joaoPauloPimentel/UNIVERSAL-MODULAR-EAR-MOUNTED-HEADPHONE-40-TO-600-MM-DRIVERS/README.md

# UNIVERSAL-MODULAR-EAR-MOUNTED-HEADPHONE-40-TO-600-MM-DRIVERS
