joaoPauloPimentel/UNIVERSAL-MODULAR-EAR-MOUNTED-HEADPHONE-40-TO-600-MM-DRIVERS/umeh2/BOM.csv

item | qty_per_pair | material | printed | source | mass_each_g | spec | tag
Cradle ring (R and L) | 2 | PETG | yes | stl/common/ring_R.stl, ring_L.stl | 33.85 | ring OD 88.7 mm, UMI-2 twist-lock groove, 5 tabs (tab radius 63.20 mm); head face down; 5 perimeters, 30 % gyroid | CAD
Saddle arm (auricle-root arch) | 2 | PETG | yes | stl/common/arm_saddle.stl | 8.47 | bar 5.5 / leg 5.5 / foot 4.5 mm, serrated clamp p 1.2 mm; printed on its side; 5 perimeters, 40 % infill | CAD
Temporal arm | 2 | PETG | yes | stl/common/arm_temporal.stl | 3.16 | bar 5.5 / leg 5.5 / foot 4.5 mm, serrated clamp p 1.2 mm; printed on its side; 5 perimeters, 40 % infill | CAD
Mastoid arm | 2 | PETG | yes | stl/common/arm_mastoid.stl | 3.36 | bar 5.5 / leg 5.5 / foot 6.0 mm, serrated clamp p 1.2 mm; printed on its side; 5 perimeters, 40 % infill | CAD
Posterior-superior arm | 2 | PETG | yes | stl/common/arm_post.stl | 3.08 | bar 5.5 / leg 5.5 / foot 4.5 mm, serrated clamp p 1.2 mm; printed on its side; 5 perimeters, 40 % infill | CAD
Saddle cap | 2 | TPU 95A | yes | stl/common/saddle_cap.stl | 6.83 | arched cap on the auricle root; flat, skin face down; the bearing face is recessed 2.5 mm for the cast liner | CAD
Saddle liner (soft silicone, cast into the cap's bearing face) | 2 | skin-safe platinum silicone Shore 00-30 (100 % modulus ~69 kPa) | no (cast) | stl/common/cast_reference/saddle_liner.stl (mould reference) | 0.92 | 2.5 mm, softens the auricle-root contact (root pressure <= 4 kPa at 55-60 mm, report §6); prime the TPU or key it mechanically; replace with the cap | C
Pad, temporal | 2 | TPU 95A, 15 % gyroid | yes | stl/common/pad_temporal.stl | 2.40 | dome 33.8 x 39.0 mm, h 6.0 mm, captive M2.5 nut | CAD
Pad, mastoid | 2 | TPU 95A, 15 % gyroid | yes | stl/common/pad_mastoid.stl | 3.49 | dome 39.0 x 49.4 mm, h 6.0 mm, captive M2.5 nut | CAD
Pad, post | 2 | TPU 95A, 15 % gyroid | yes | stl/common/pad_post.stl | 2.75 | dome 33.8 x 39.0 mm, h 6.0 mm, captive M2.5 nut | CAD
Cable anchor | 2 | PETG | yes | stl/common/cable_anchor.stl | 3.92 | holds the 2-pin socket; clip post; printed ON ITS SIDE (post bending in-layer) | CAD
Cable clip | 2 | TPU 95A | yes | stl/common/cable_clip.stl | 0.93 | routing guide for a 3.8 mm cable (interference 0.05 mm) | CAD
UMI anti-rattle foam strips (3 per side) | 6 | PU foam, PSA backed | no (die-cut) | stl/common/gasket_umi.stl (cutting template) | 0.03 | 1.6 mm sheet, CFD25 46 kPa (window 43-50 kPa), on the lug tops | C
Silicone pad facing, temporal + mastoid | 4 | platinum-cure silicone Shore 10-30A | no (cast) | stl/common/cast_reference/pad_face_*.stl (mould reference) | 0.95 | 0.8 mm layer on the dome (static friction demand, report §9) | C
Seal pad (sealed-front option C, not in the default build) | 0 | TPU 95A, 15 % gyroid | optional | stl/common/seal_pad.stl |  | ring 62.0/92.0 mm; see report §16 (needs ~1 kPa on <= 30 kg/m3 foam to seal) | C
Baffle 40 mm | 2 | PETG | yes | stl/module_40mm/baffle_40.stl | 17.67 | aperture 35.2 mm, UMI-2 lugs; head face down | CAD
Cup 40 mm (R and L: eye position) | 2 | PETG | yes | stl/module_40mm/cup_40_R.stl, cup_40_L.stl | 16.54 | wall 1.2 mm, height 18.2 mm, link eye at (-15.0, 7.0) mm | CAD
Driver rim gasket 40 mm | 2 | TPU 95A | yes | stl/module_40mm/gasket_driver_40.stl | 0.36 | 1.0 mm, squeeze 0.3 mm | CAD
Felt disc 40 mm | 2 | wool/polyester felt | no | die-cut | 0.38 | Ø35.2 x 2.0 mm, hole Ø7.5 at the link eye (pushed over the boss), flow resistivity ~40 kPa s/m2 [A] | C
Felt PSA rim 40 mm | 2 | acrylic PSA transfer tape | no | die-cut ring |  | OD 35.2 / ID 31.2 mm; 90° peel on PETG >= 3 N/cm [A], mass < 0.02 g | A
Cup screws 40 mm | 6 | A2 stainless | no | ISO 10642 countersunk | 0.55 | M2.5x25 cut to 22.5 mm (engagement 4.3 mm in the baffle insert) | C
Driver 40 mm | 2 | - | no | user supplied | 15.00 | rim OD 40.5 mm, depth 10.0 mm (placeholder values [A]: measure and re-run) | A
Baffle 45 mm | 2 | PETG | yes | stl/module_45mm/baffle_45.stl | 16.24 | aperture 39.6 mm, UMI-2 lugs; head face down | CAD
Cup 45 mm (R and L: eye position) | 2 | PETG | yes | stl/module_45mm/cup_45_R.stl, cup_45_L.stl | 19.79 | wall 1.2 mm, height 19.2 mm, link eye at (-18.0, 7.0) mm | CAD
Driver rim gasket 45 mm | 2 | TPU 95A | yes | stl/module_45mm/gasket_driver_45.stl | 0.45 | 1.0 mm, squeeze 0.3 mm | CAD
Felt disc 45 mm | 2 | wool/polyester felt | no | die-cut | 0.48 | Ø39.4 x 2.0 mm, hole Ø7.5 at the link eye (pushed over the boss), flow resistivity ~40 kPa s/m2 [A] | C
Felt PSA rim 45 mm | 2 | acrylic PSA transfer tape | no | die-cut ring |  | OD 39.4 / ID 35.4 mm; 90° peel on PETG >= 3 N/cm [A], mass < 0.02 g | A
Cup screws 45 mm | 6 | A2 stainless | no | ISO 10642 countersunk | 0.55 | M2.5x25 cut to 23.5 mm (engagement 4.3 mm in the baffle insert) | C
Driver 45 mm | 2 | - | no | user supplied | 19.00 | rim OD 45.5 mm, depth 11.0 mm (placeholder values [A]: measure and re-run) | A
Baffle 50 mm | 2 | PETG | yes | stl/module_50mm/baffle_50.stl | 15.29 | aperture 44.0 mm, UMI-2 lugs; head face down | CAD
Cup 50 mm (R and L: eye position) | 2 | PETG | yes | stl/module_50mm/cup_50_R.stl, cup_50_L.stl | 23.54 | wall 1.2 mm, height 20.0 mm, link eye at (-19.0, 7.0) mm | CAD
Driver rim gasket 50 mm | 2 | TPU 95A | yes | stl/module_50mm/gasket_driver_50.stl | 0.56 | 1.0 mm, squeeze 0.3 mm | CAD
Felt disc 50 mm | 2 | wool/polyester felt | no | die-cut | 0.58 | Ø43.6 x 2.0 mm, hole Ø7.5 at the link eye (pushed over the boss), flow resistivity ~40 kPa s/m2 [A] | C
Felt PSA rim 50 mm | 2 | acrylic PSA transfer tape | no | die-cut ring |  | OD 43.6 / ID 39.6 mm; 90° peel on PETG >= 3 N/cm [A], mass < 0.02 g | A
Cup screws 50 mm | 6 | A2 stainless | no | ISO 10642 countersunk | 0.55 | M2.5x25 cut to 24.5 mm (engagement 4.5 mm in the baffle insert) | C
Driver 50 mm | 2 | - | no | user supplied | 26.00 | rim OD 50.5 mm, depth 12.0 mm (placeholder values [A]: measure and re-run) | A
Baffle 55 mm | 2 | PETG | yes | stl/module_55mm/baffle_55.stl | 13.42 | aperture 48.4 mm, UMI-2 lugs; head face down | CAD
Cup 55 mm (R and L: eye position) | 2 | PETG | yes | stl/module_55mm/cup_55_R.stl, cup_55_L.stl | 26.74 | wall 1.2 mm, height 21.0 mm, link eye at (-18.0, 7.0) mm | CAD
Driver rim gasket 55 mm | 2 | TPU 95A | yes | stl/module_55mm/gasket_driver_55.stl | 0.67 | 1.0 mm, squeeze 0.3 mm | CAD
Felt disc 55 mm | 2 | wool/polyester felt | no | die-cut | 0.72 | Ø48.5 x 2.0 mm, hole Ø7.5 at the link eye (pushed over the boss), flow resistivity ~40 kPa s/m2 [A] | C
Felt PSA rim 55 mm | 2 | acrylic PSA transfer tape | no | die-cut ring |  | OD 48.5 / ID 44.5 mm; 90° peel on PETG >= 3 N/cm [A], mass < 0.02 g | A
Cup screws 55 mm | 6 | A2 stainless | no | ISO 10642 countersunk | 0.55 | M2.5x25 (engagement 4.0 mm in the baffle insert) | C
Driver 55 mm | 2 | - | no | user supplied | 33.00 | rim OD 55.5 mm, depth 13.0 mm (placeholder values [A]: measure and re-run) | A
Baffle 60 mm | 2 | PETG | yes | stl/module_60mm/baffle_60.stl | 11.38 | aperture 52.8 mm, UMI-2 lugs; head face down | CAD
Cup 60 mm (R and L: eye position) | 2 | PETG | yes | stl/module_60mm/cup_60_R.stl, cup_60_L.stl | 29.95 | wall 1.2 mm, height 22.0 mm, link eye at (-18.0, 7.0) mm | CAD
Driver rim gasket 60 mm | 2 | TPU 95A | yes | stl/module_60mm/gasket_driver_60.stl | 0.80 | 1.0 mm, squeeze 0.3 mm | CAD
Felt disc 60 mm | 2 | wool/polyester felt | no | die-cut | 0.88 | Ø53.5 x 2.0 mm, hole Ø7.5 at the link eye (pushed over the boss), flow resistivity ~40 kPa s/m2 [A] | C
Felt PSA rim 60 mm | 2 | acrylic PSA transfer tape | no | die-cut ring |  | OD 53.5 / ID 49.5 mm; 90° peel on PETG >= 3 N/cm [A], mass < 0.02 g | A
Cup screws 60 mm | 6 | A2 stainless | no | ISO 10642 countersunk | 0.55 | M2.5x25 (engagement 3.0 mm in the baffle insert) | C
Driver 60 mm | 2 | - | no | user supplied | 40.00 | rim OD 60.5 mm, depth 14.0 mm (placeholder values [A]: measure and re-run) | A
Arm screws | 16 | A2 stainless | no | ISO 7380 / ISO 4762 | 0.95 | M3x10 (engagement 4.2 mm), torque 0.1 N m (torque driver); inserts 11.0 mm apart | C
Arm wave spring washers | 16 | spring steel | no | wave washer | 0.03 | M3: ID 3.2, OD <= 6.0 mm, >= 100 N flat load, rate <= 200 N/mm | C
Heat-set inserts, arm tabs | 16 | brass | no | knurled heat-set | 0.33 | M3, OD 4.6 x 5.0 mm | DS
Cable anchor screws | 4 | A2 stainless | no | ISO 4762 | 0.95 | M3x8 (engagement 3.7 mm), torque 0.1 N m, with a wave washer (next line) | C
Anchor wave spring washers | 4 | spring steel | no | wave washer | 0.04 | M3: ID 3.2, OD <= 6.0 mm, >= 100 N flat load, rate <= 200 N/mm (same requirement as the arm joints) | C
Heat-set inserts, cable tab | 4 | brass | no | knurled heat-set | 0.33 | M3, OD 4.6 x 5.0 mm | DS
Clip screw + nut | 2 | A2 stainless | no | ISO 4762 + ISO 4032 | 1.23 | M3x16 | DS
Heat-set inserts, baffle (cup screws; per module pair) | 6 | brass | no | knurled heat-set | 0.20 | M2.5, OD 4.0 x 4.0 mm | DS
Pad screws + nuts | 6 | A2 stainless | no | ISO 7380 + ISO 4032 | 0.72 | M2.5x10 (pad to arm foot) | DS
Saddle-cap pin | 2 | A2 stainless | no | M2x12 + nut | 0.45 | hinge pin of the saddle cap | DS
Link eye screw + insert + washer | 2 | A2 / brass | no | M2.5x8 ISO 7380 + heat-set M2.5 | 0.85 | clamps the eye sleeve to the cup boss | DS
Link eye sleeve | 2 | brass tube | no | cut | 1.31 | OD 7.5 x ID 2.7 x 4 mm (keeps the eye inner radius >= 1.5 d) | C
Occipital link wire | 1 | music wire ASTM A228 | no | formed | 22.87 | Ø2.5 mm, 4 apex coils (mean Ø from linkspring.DC_COIL), length 443 mm + coils, free half-gap 100.6 mm | C
Link sleeve | 1 | silicone tube | no | tube | 12.39 | ID 2.5 mm (= wire), 2 mm wall, 398 mm (90 % of the arc; the eye bends and the apex coil bare): skin and hair contact | A
2-pin 0.78 mm socket + JST pigtail | 2 | - | no | catalogue | 2.00 | in the cable anchor | A
