joaoPauloPimentel/UNIVERSAL-MODULAR-EAR-MOUNTED-HEADPHONE-40-TO-600-MM-DRIVERS/umeh2/stl/assembly/UMEH-2_assembly_55mm_R.3mf

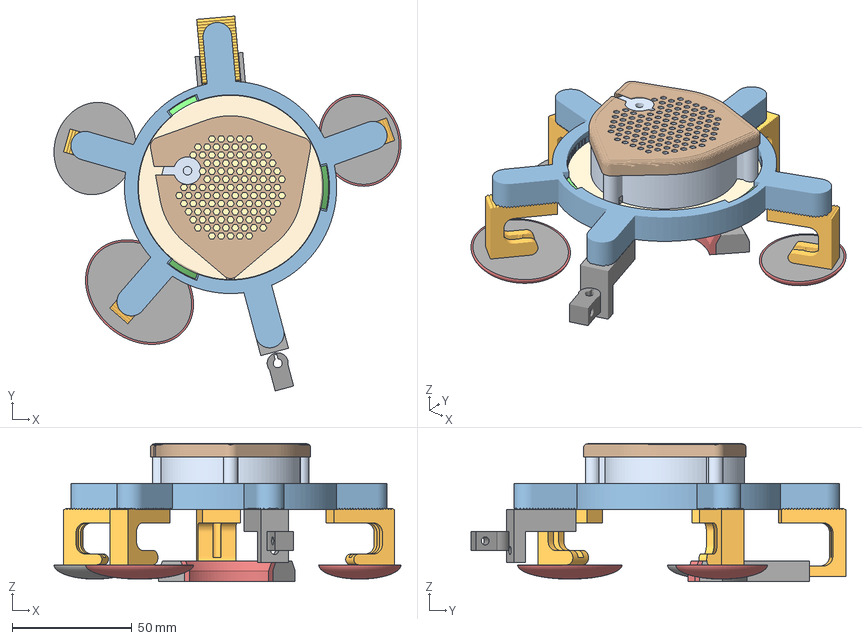
[picture p17: CAD file, 2026-09-30]
umeh2/stl/assembly/UMEH-2_assembly_55mm_R.3mf
145.0 x 156.7 x 57.7 mm
ring
gasket_umi
arm_saddle
arm_temporal
arm_mastoid
arm_post
saddle_cap
pad_temporal
pad_mastoid
pad_post
cable_anchor
cable_clip
saddle_liner
pad_face_temporal
pad_face_mastoid
baffle
gasket_driver
driver_visual
felt
cup
cup_cap
front_foam
