joaoPauloPimentel/UNIVERSAL-MODULAR-EAR-MOUNTED-HEADPHONE-40-TO-600-MM-DRIVERS/umeh2/stl/common/gasket_umi.stl

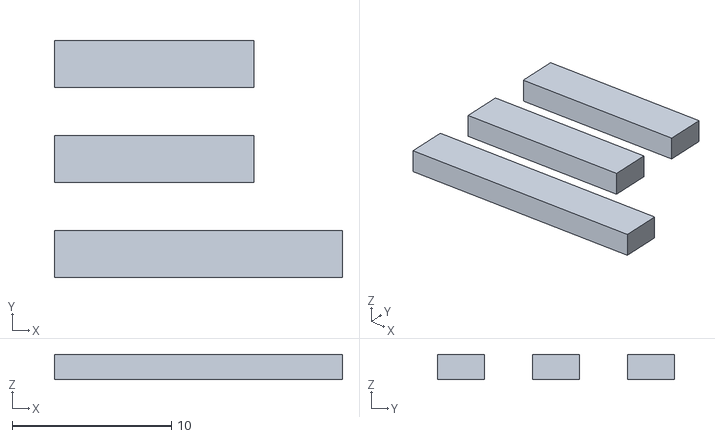
[picture p19: CAD file, 2026-09-30]
umeh2/stl/common/gasket_umi.stl
18.1 x 14.9 x 1.60
