joaoPauloPimentel/UNIVERSAL-MODULAR-EAR-MOUNTED-HEADPHONE-40-TO-600-MM-DRIVERS/umeh2/stl/module_40mm/front_foam_40_template.stl

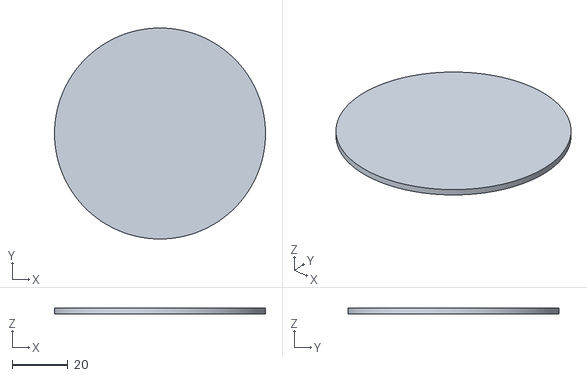
[picture p20: CAD file, 2026-09-30]
umeh2/stl/module_40mm/front_foam_40_template.stl
76.0 x 76.0 x 2.00
