joaoPauloPimentel/UNIVERSAL-MODULAR-EAR-MOUNTED-HEADPHONE-40-TO-600-MM-DRIVERS/umeh2/stl/common/cast_reference/pad_face_mastoid.stl

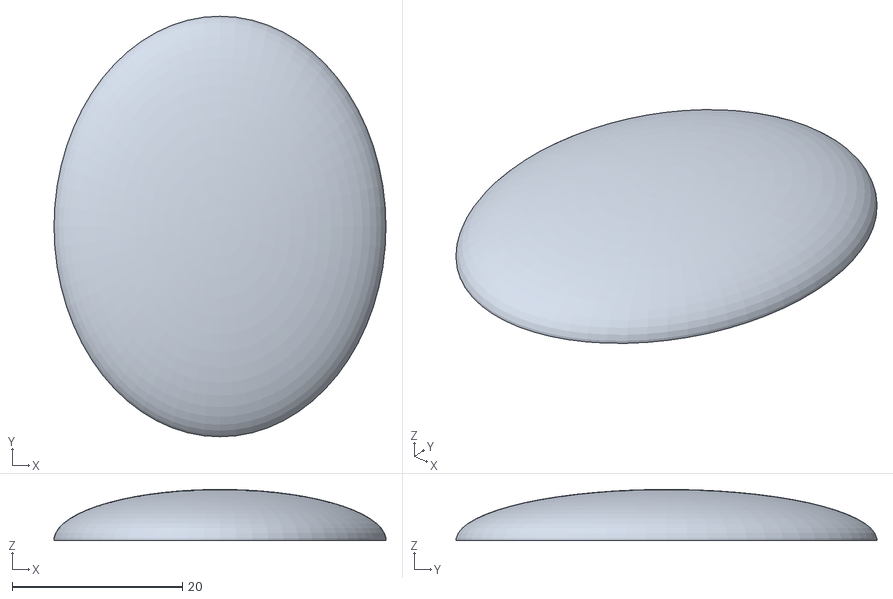
[picture p21: CAD file, 2026-09-30]
umeh2/stl/common/cast_reference/pad_face_mastoid.stl
39.0 x 49.3 x 5.99
