joaoPauloPimentel/UNIVERSAL-MODULAR-EAR-MOUNTED-HEADPHONE-40-TO-600-MM-DRIVERS/umeh2/stl/common/pad_temporal.stl

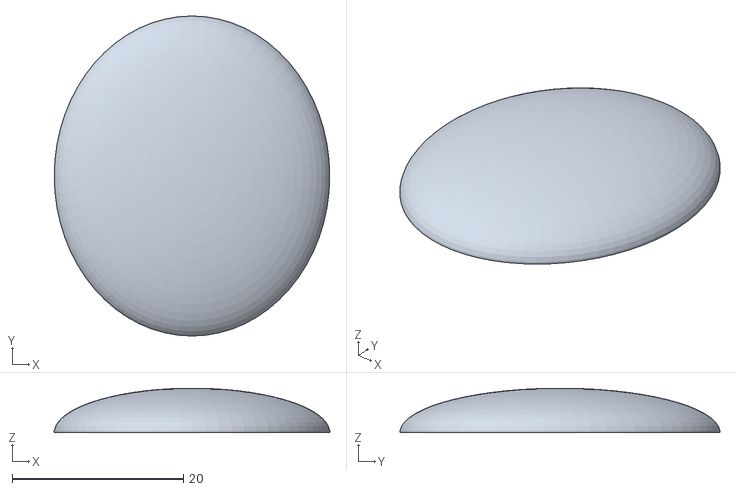
[picture p22: CAD file, 2026-09-30]
umeh2/stl/common/pad_temporal.stl
32.2 x 37.4 x 5.19
