joaoPauloPimentel/UNIVERSAL-MODULAR-EAR-MOUNTED-HEADPHONE-40-TO-600-MM-DRIVERS/umeh2/stl/module_40mm/cup_cap_40_R.stl

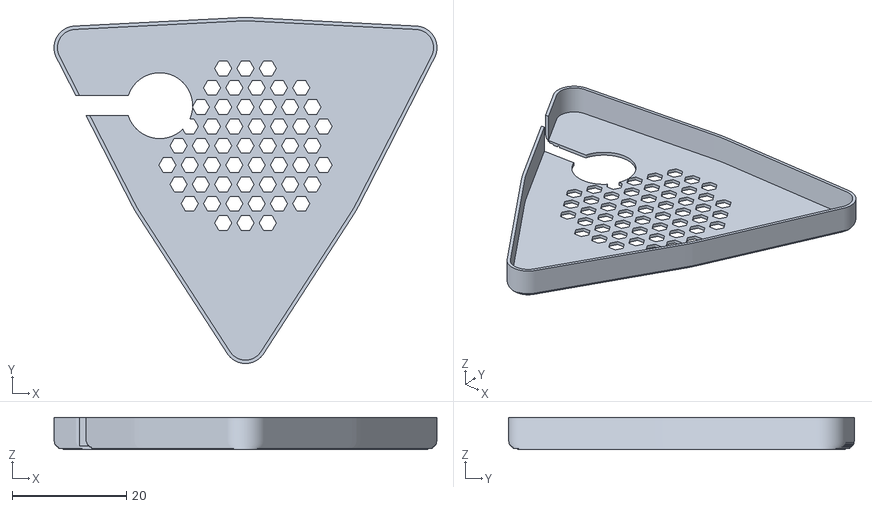
[picture p23: CAD file, 2026-09-30]
umeh2/stl/module_40mm/cup_cap_40_R.stl
67.0 x 60.5 x 5.60
