joaoPauloPimentel/UNIVERSAL-MODULAR-EAR-MOUNTED-HEADPHONE-40-TO-600-MM-DRIVERS/umeh2/stl/module_45mm/cup_cap_45_R.stl

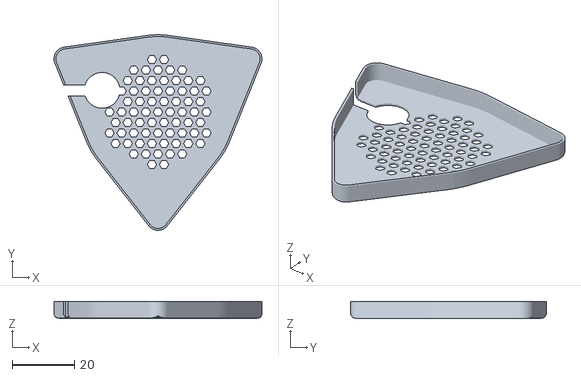
[picture p24: CAD file, 2026-09-30]
umeh2/stl/module_45mm/cup_cap_45_R.stl
67.0 x 63.0 x 5.60
