joaoPauloPimentel/UNIVERSAL-MODULAR-EAR-MOUNTED-HEADPHONE-40-TO-600-MM-DRIVERS/umeh2/stl/module_50mm/cup_cap_50_R.stl

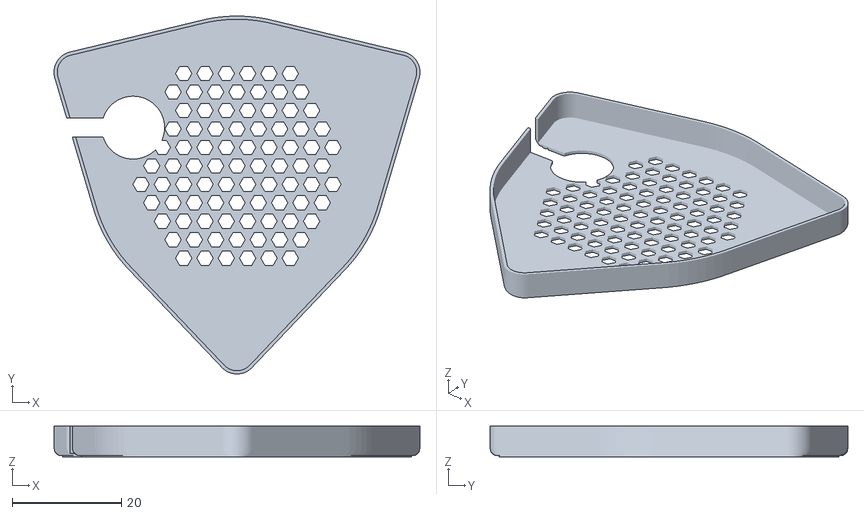
[picture p25: CAD file, 2026-09-30]
umeh2/stl/module_50mm/cup_cap_50_R.stl
67.0 x 65.5 x 5.60
