joaoPauloPimentel/UNIVERSAL-MODULAR-EAR-MOUNTED-HEADPHONE-40-TO-600-MM-DRIVERS/umeh2/stl/module_55mm/cup_cap_55_L.stl

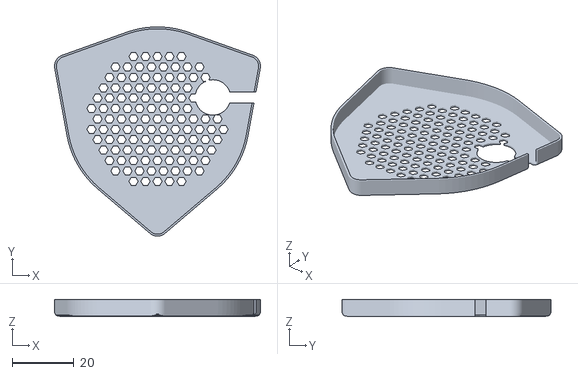
[picture p26: CAD file, 2026-09-30]
umeh2/stl/module_55mm/cup_cap_55_L.stl
67.0 x 68.0 x 5.60
