joaoPauloPimentel/UNIVERSAL-MODULAR-EAR-MOUNTED-HEADPHONE-40-TO-600-MM-DRIVERS/umeh2/stl/module_60mm/cup_cap_60_L.stl

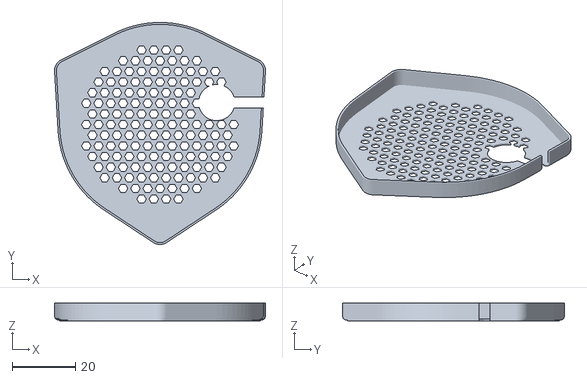
[picture p27: CAD file, 2026-09-30]
umeh2/stl/module_60mm/cup_cap_60_L.stl
67.0 x 70.5 x 5.60
