joaoPauloPimentel/UNIVERSAL-MODULAR-EAR-MOUNTED-HEADPHONE-40-TO-600-MM-DRIVERS/umeh2/stl/common/arm_mastoid.stl

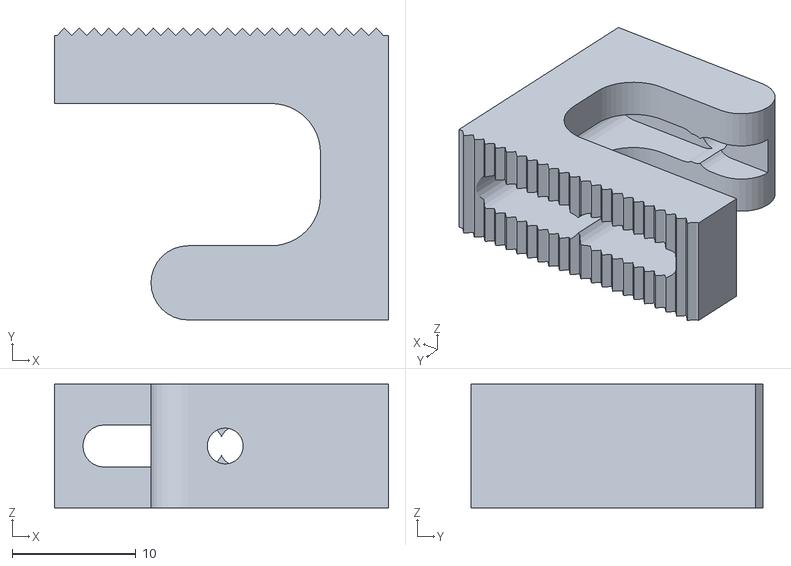
[picture p28: CAD file, 2026-09-30]
umeh2/stl/common/arm_mastoid.stl
27.0 x 23.6 x 10.0
