joaoPauloPimentel/UNIVERSAL-MODULAR-EAR-MOUNTED-HEADPHONE-40-TO-600-MM-DRIVERS/umeh2/stl/common/cast_reference/saddle_liner.stl

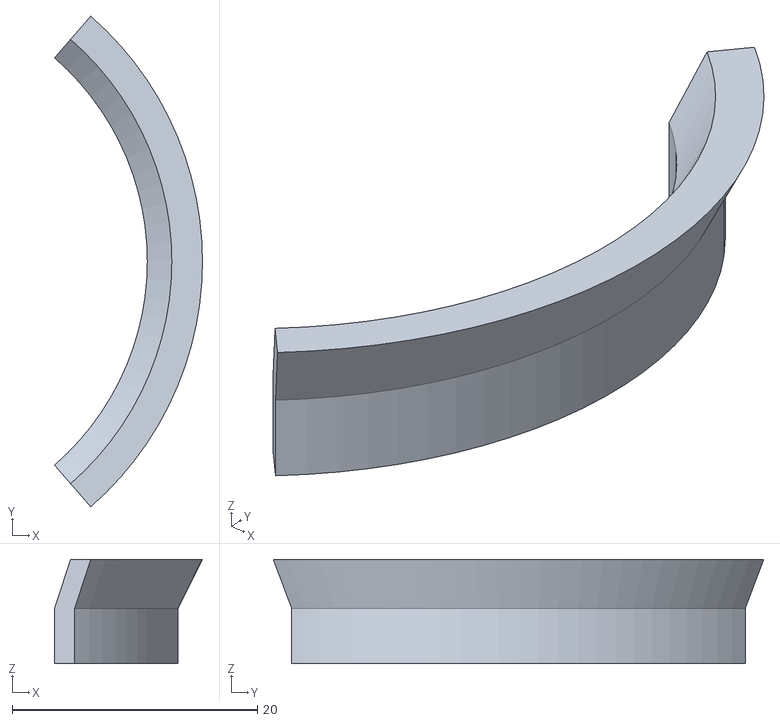
[picture p29: CAD file, 2026-09-30]
umeh2/stl/common/cast_reference/saddle_liner.stl
12.1 x 40.0 x 8.50
