joaoPauloPimentel/UNIVERSAL-MODULAR-EAR-MOUNTED-HEADPHONE-40-TO-600-MM-DRIVERS/umeh2/stl/module_40mm/cup_40_L.stl

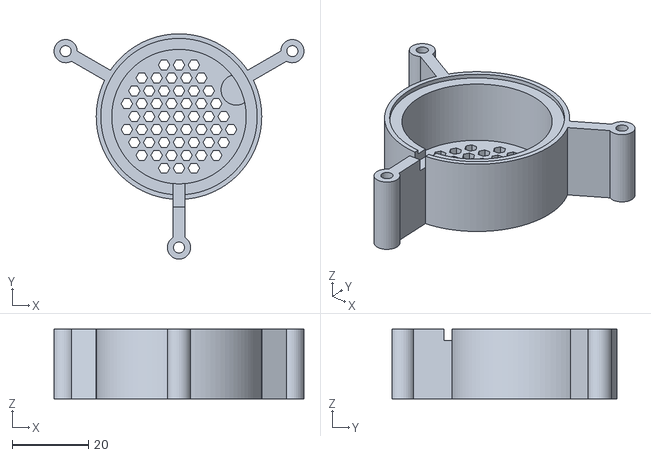
[picture p31: CAD file, 2026-09-30]
umeh2/stl/module_40mm/cup_40_L.stl
65.4 x 59.0 x 18.2
