joaoPauloPimentel/UNIVERSAL-MODULAR-EAR-MOUNTED-HEADPHONE-40-TO-600-MM-DRIVERS/umeh2/stl/module_45mm/gasket_driver_45.stl

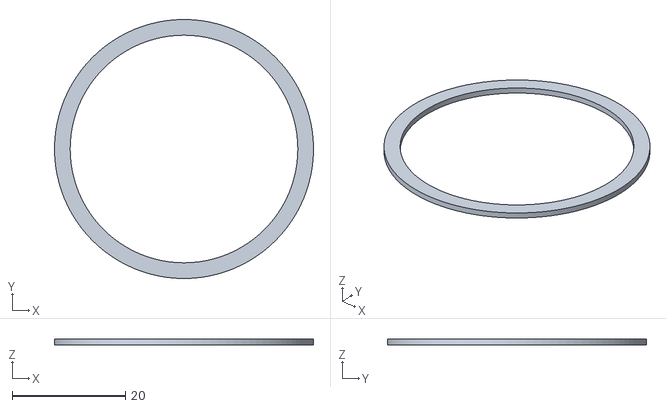
[picture p32: CAD file, 2026-09-30]
umeh2/stl/module_45mm/gasket_driver_45.stl
45.7 x 45.7 x 1.00
