joaoPauloPimentel/UNIVERSAL-MODULAR-EAR-MOUNTED-HEADPHONE-40-TO-600-MM-DRIVERS/umeh2/stl/module_50mm/gasket_driver_50.stl

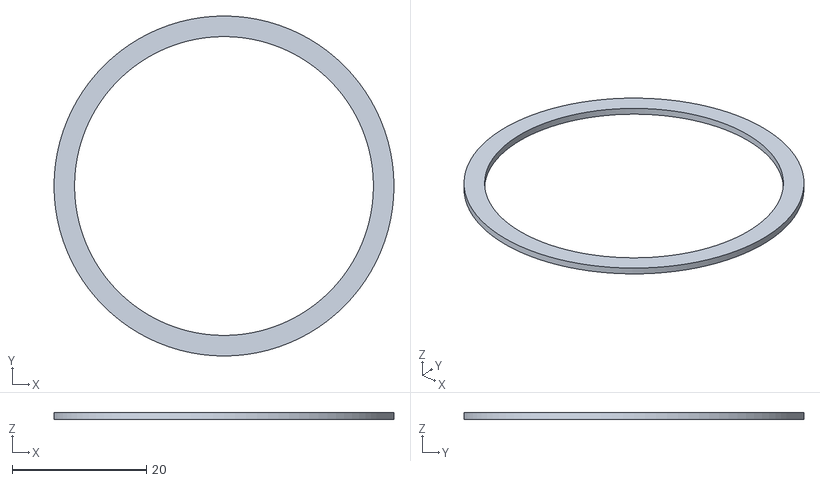
[picture p33: CAD file, 2026-09-30]
umeh2/stl/module_50mm/gasket_driver_50.stl
50.7 x 50.7 x 1.00
