joaoPauloPimentel/UNIVERSAL-MODULAR-EAR-MOUNTED-HEADPHONE-40-TO-600-MM-DRIVERS/umeh2/stl/module_55mm/gasket_driver_55.stl

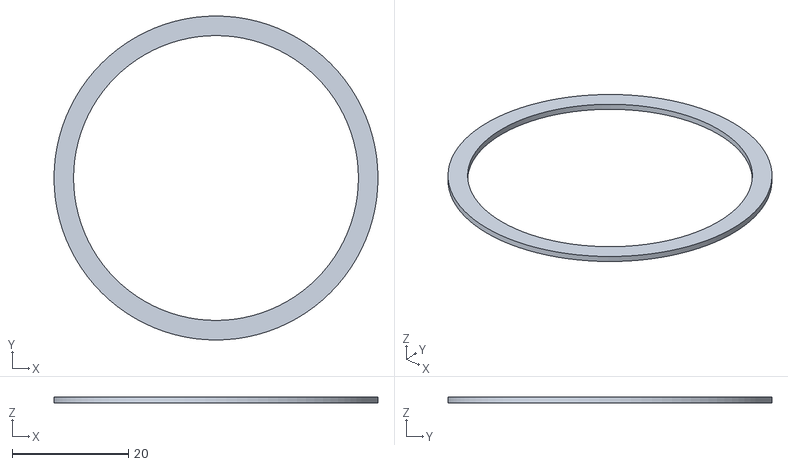
[picture p34: CAD file, 2026-09-30]
umeh2/stl/module_55mm/gasket_driver_55.stl
55.7 x 55.7 x 1.00
