joaoPauloPimentel/UNIVERSAL-MODULAR-EAR-MOUNTED-HEADPHONE-40-TO-600-MM-DRIVERS/umeh2/stl/common/cable_clip.stl

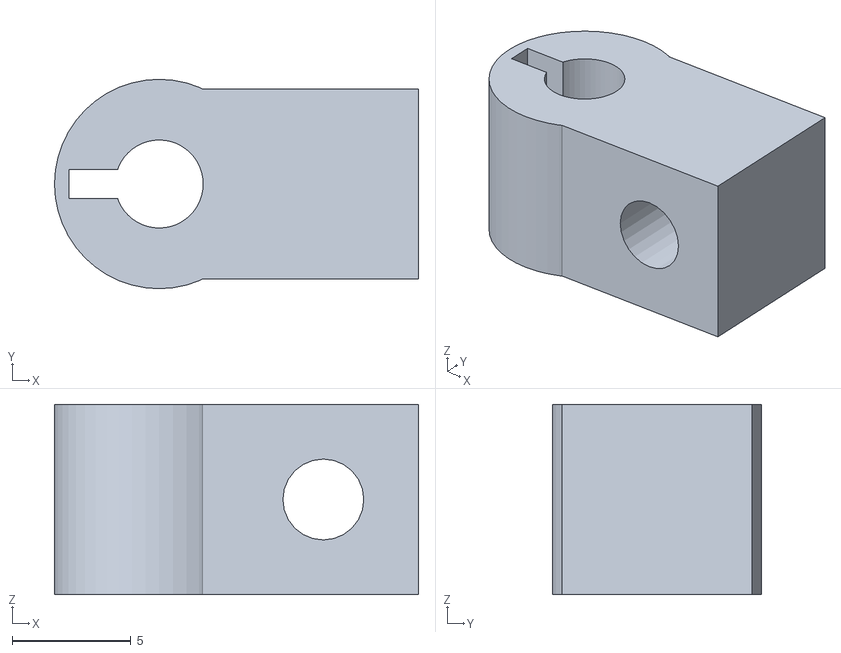
[picture p36: CAD file, 2026-09-30]
umeh2/stl/common/cable_clip.stl
15.3 x 8.80 x 8.00
