joaoPauloPimentel/UNIVERSAL-MODULAR-EAR-MOUNTED-HEADPHONE-40-TO-600-MM-DRIVERS/umeh2/stl/module_45mm/baffle_45.stl

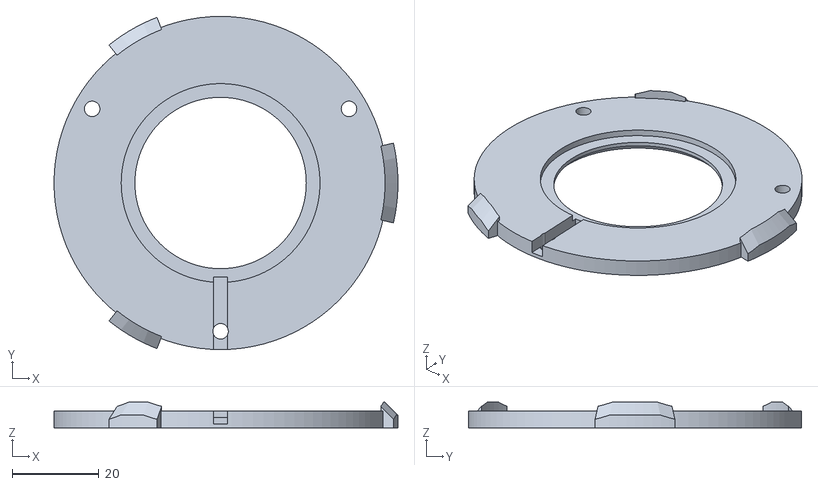
[picture p37: CAD file, 2026-09-30]
umeh2/stl/module_45mm/baffle_45.stl
79.5 x 77.0 x 6.00
