joaoPauloPimentel/UNIVERSAL-MODULAR-EAR-MOUNTED-HEADPHONE-40-TO-600-MM-DRIVERS/umeh2/stl/module_55mm/cup_55_R.stl

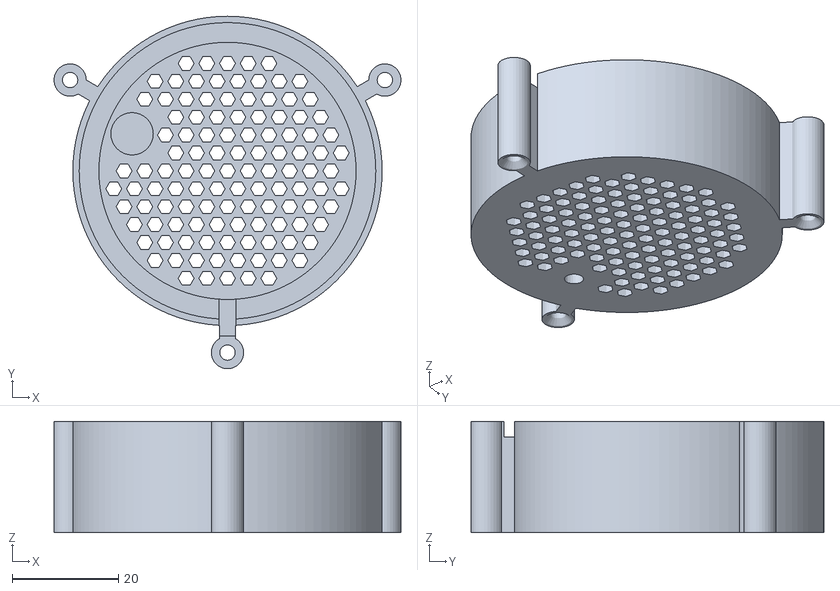
[picture p39: CAD file, 2026-09-30]
umeh2/stl/module_55mm/cup_55_R.stl
65.4 x 66.5 x 21.0
