joaoPauloPimentel/UNIVERSAL-MODULAR-EAR-MOUNTED-HEADPHONE-40-TO-600-MM-DRIVERS/umeh2/stl/module_60mm/cup_60_R.stl

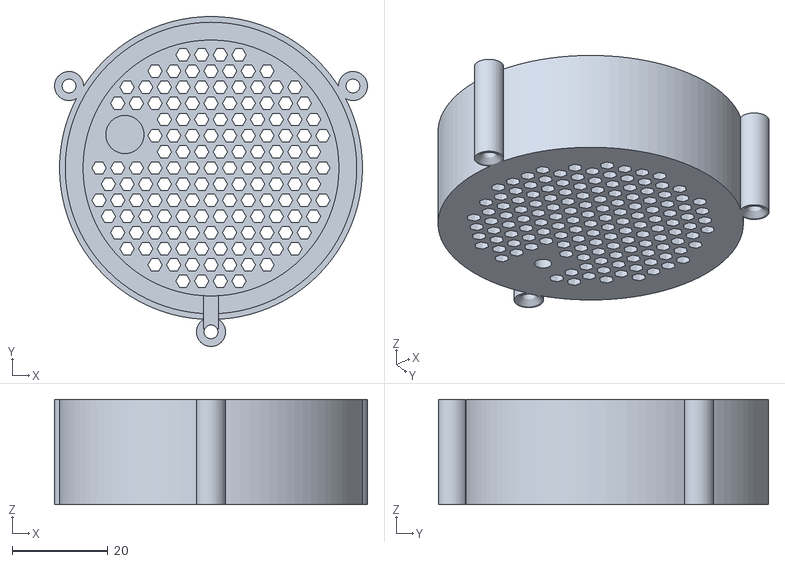
[picture p40: CAD file, 2026-09-30]
umeh2/stl/module_60mm/cup_60_R.stl
65.4 x 69.0 x 22.0
