joaoPauloPimentel/UNIVERSAL-MODULAR-EAR-MOUNTED-HEADPHONE-40-TO-600-MM-DRIVERS/umeh2/stl/common/saddle_cap.stl

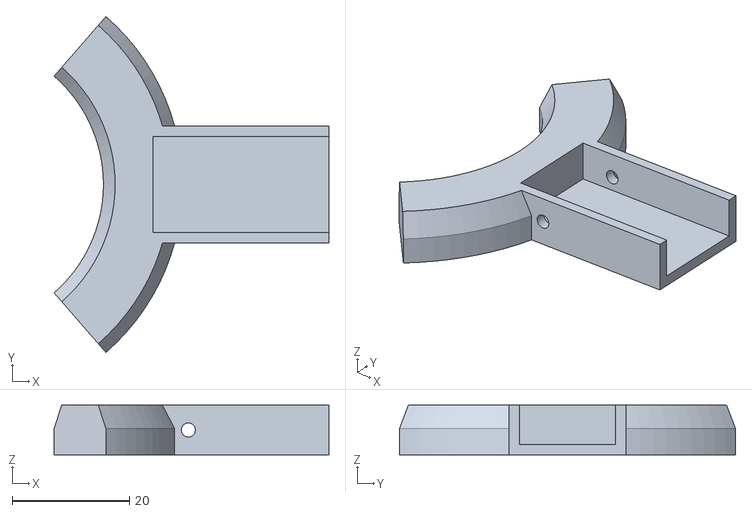
[picture p41: CAD file, 2026-09-30]
umeh2/stl/common/saddle_cap.stl
46.9 x 57.4 x 8.50
