joaoPauloPimentel/UNIVERSAL-MODULAR-EAR-MOUNTED-HEADPHONE-40-TO-600-MM-DRIVERS/umeh2/stl/module_40mm/gasket_driver_40.stl

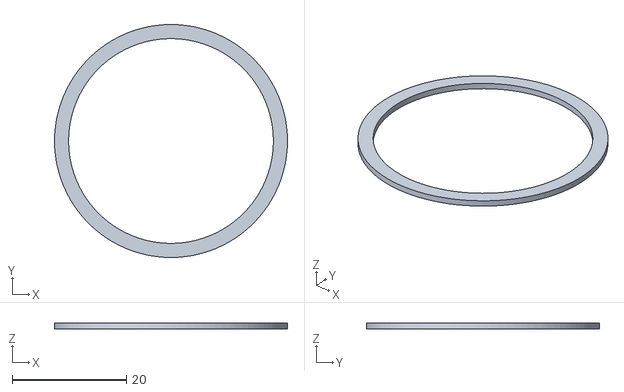
[picture p42: CAD file, 2026-09-30]
umeh2/stl/module_40mm/gasket_driver_40.stl
40.7 x 40.7 x 1.00
