joaoPauloPimentel/UNIVERSAL-MODULAR-EAR-MOUNTED-HEADPHONE-40-TO-600-MM-DRIVERS/umeh2/stl/module_45mm/cup_45_R.stl

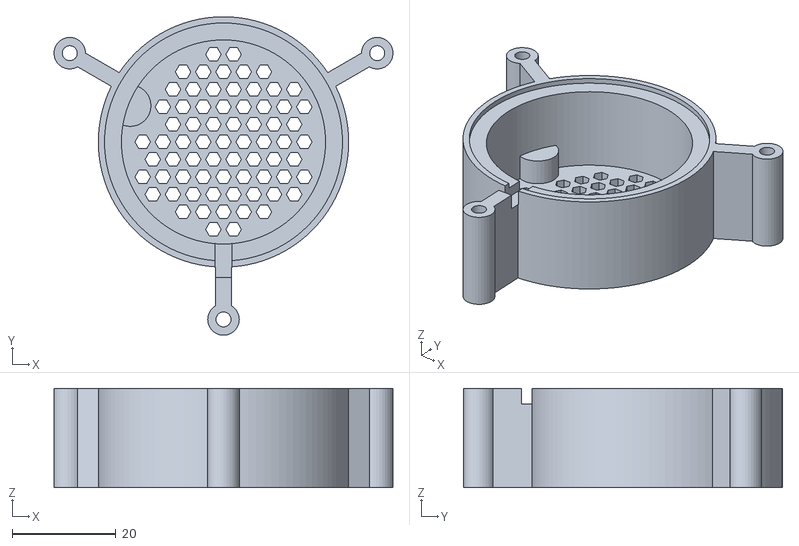
[picture p43: CAD file, 2026-09-30]
umeh2/stl/module_45mm/cup_45_R.stl
65.4 x 61.5 x 19.2
