joaoPauloPimentel/UNIVERSAL-MODULAR-EAR-MOUNTED-HEADPHONE-40-TO-600-MM-DRIVERS/umeh2/stl/module_50mm/cup_50_L.stl

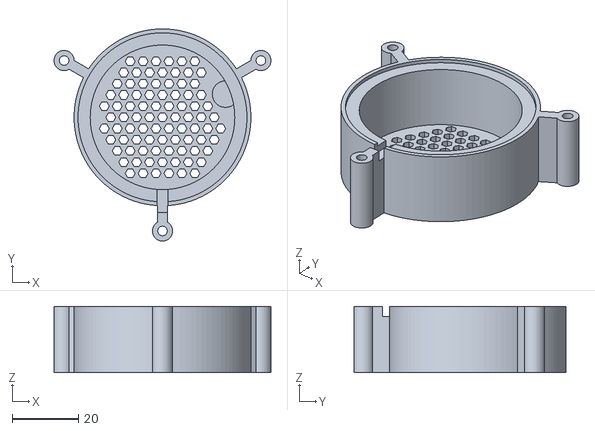
[picture p44: CAD file, 2026-09-30]
umeh2/stl/module_50mm/cup_50_L.stl
65.4 x 64.0 x 20.0
