joaoPauloPimentel/UNIVERSAL-MODULAR-EAR-MOUNTED-HEADPHONE-40-TO-600-MM-DRIVERS/umeh2/stl/common/arm_saddle.stl

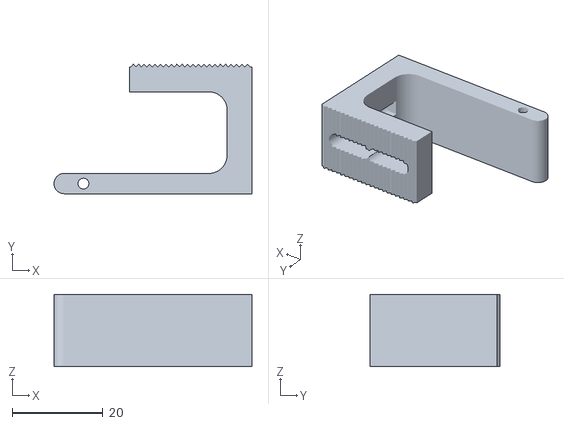
[picture p46: CAD file, 2026-09-30]
umeh2/stl/common/arm_saddle.stl
43.7 x 28.6 x 16.0
