joaoPauloPimentel/UNIVERSAL-MODULAR-EAR-MOUNTED-HEADPHONE-40-TO-600-MM-DRIVERS/umeh2/stl/module_60mm/gasket_driver_60.stl

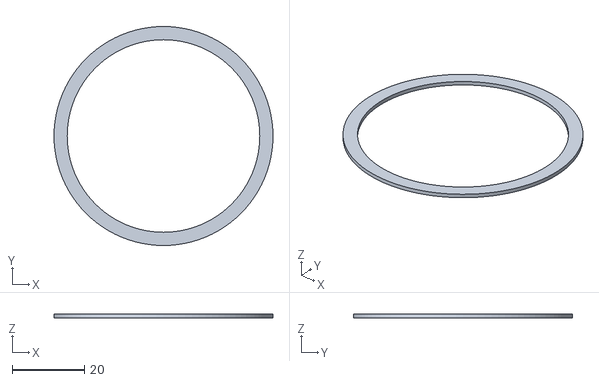
[picture p48: CAD file, 2026-09-30]
umeh2/stl/module_60mm/gasket_driver_60.stl
60.7 x 60.7 x 1.00
