joaoPauloPimentel/UNIVERSAL-MODULAR-EAR-MOUNTED-HEADPHONE-40-TO-600-MM-DRIVERS/umeh2/stl/common/seal_pad.stl

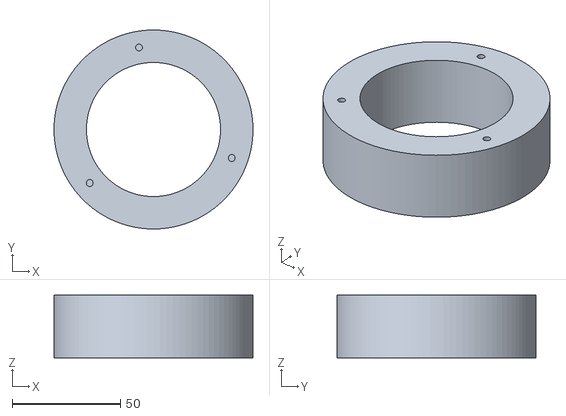
[picture p49: CAD file, 2026-09-30]
umeh2/stl/common/seal_pad.stl
92.0 x 92.0 x 29.0
