joaoPauloPimentel/UNIVERSAL-MODULAR-EAR-MOUNTED-HEADPHONE-40-TO-600-MM-DRIVERS/umeh2/stl/common/cable_anchor.stl

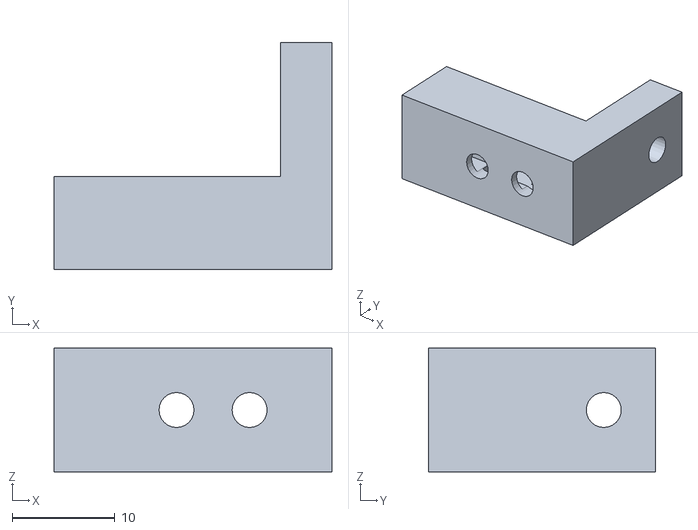
[picture p50: CAD file, 2026-09-30]
umeh2/stl/common/cable_anchor.stl
27.0 x 22.0 x 12.0
