joaoPauloPimentel/UNIVERSAL-MODULAR-EAR-MOUNTED-HEADPHONE-40-TO-600-MM-DRIVERS/umeh2/stl/common/pad_post.stl

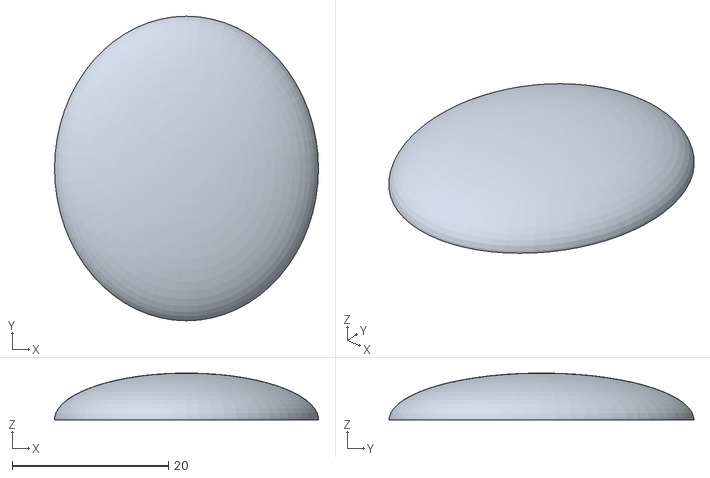
[picture p51: CAD file, 2026-09-30]
umeh2/stl/common/pad_post.stl
33.8 x 39.0 x 5.99
