joaoPauloPimentel/UNIVERSAL-MODULAR-EAR-MOUNTED-HEADPHONE-40-TO-600-MM-DRIVERS/umeh2/stl/common/pad_mastoid.stl

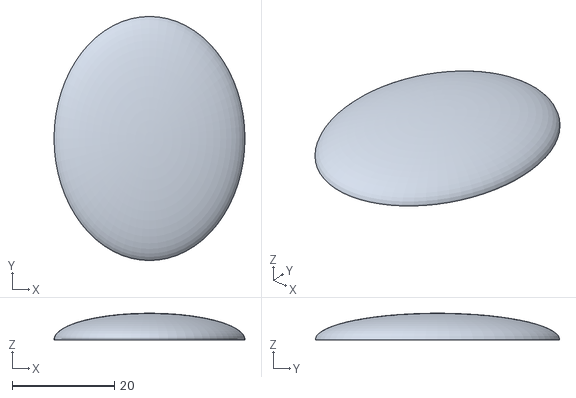
[picture p52: CAD file, 2026-09-30]
umeh2/stl/common/pad_mastoid.stl
37.4 x 47.7 x 5.19
