joaoPauloPimentel/UNIVERSAL-MODULAR-EAR-MOUNTED-HEADPHONE-40-TO-600-MM-DRIVERS/umeh2/stl/common/ring_R.stl

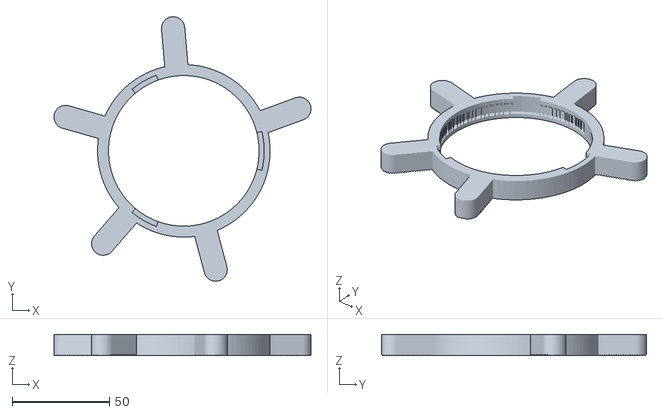
[picture p53: CAD file, 2026-09-30]
umeh2/stl/common/ring_R.stl
132.1 x 136.0 x 11.0
