joaoPauloPimentel/UNIVERSAL-MODULAR-EAR-MOUNTED-HEADPHONE-40-TO-600-MM-DRIVERS/umeh2/cad/generated_params.scad

// AUTO-GENERATED by calc/run_all.py — do not edit by hand.
// Every value below is an output of the UMEH-2 engineering calculations
// (see report/ENGINEERING_REPORT.md for the derivation of each one).
bore_d = 77.4;
spig_d = 77.0;
lug_h = 2.5;
groove_rclr = 0.35;
floor_t = 2.0;
groove_h = 4.1208;
lip_t = 2.2;
ring_od = 88.7;
tabs = [[95.0, 63.2], [20.0, 63.2], [229.0, 63.2], [285.0, 63.2], [164.0, 63.2]];
tab_w = 12.0;
tab_t = 10.9708;
tab_ins_pitch = 11.0;
tab_ins_hole = 4.0;
tab_ins_L = 5.0;
notch_extra = 2.0;
lugs = [[0.0, 26.0], [120.0, 18.0], [240.0, 18.0]];
stop_a = [54.0, 65.0];
use_lock = false;
lock_clear = 2.4;
lock_pilot = 1.6;
twist = 40.0;
gasket_umi_t = 1.2;
gasket_squeeze = 0.35;
umi_mode = "foam";
foam_t = 1.6;
foam_eps = 0.35;
lug_ramp_c = 1.0;
lug_ramp_L = 3.5;
z_mod0 = 2.0;
standoff = 29.0;
saddle_skin_gap = 1.0;
pad_h = 6.0;
bar_r0 = 44.2;
bar_r1 = 71.2;
bar_t = 5.5;
leg_r = 65.7;
leg_t = 5.5;
fillet_r = 4.0;
saddle_r = 32.0;
pad_r = 57.5;
saddle_arm_w = 16.0;
arm_w = 10.0;
foot_t = 4.5;
foot_t_mastoid = 6.0;
tab_r = 63.2;
slot_adj = 4.0;
arm_screw_clear = 3.4;
pad_screw_clear = 2.9;
eye_seat_h = 1.5;
eye_seat_d = 10.5;
cap_pin_clear = 2.4;
saddle_cap_L = 40.0;
saddle_cap_wall = 2.0;
saddle_strip_L = 26.0;
pad_t_a = 33.8;
pad_t_b = 39.0;
pad_m_a = 39.0;
pad_m_b = 49.4;
pad_nut_d = 5.4;
pad_nut_h = 2.2;
pad_skin_cover = 2.0;
pad_face_t = 0.8;
lug_t = 3.0;
baffle_h = 4.1;
aperture_d = 52.8;
aperture_chamfer = 1.5;
seat_z = 2.4;
driver_mount_d = 60.5;
driver_pocket_clr = 0.22;
cup_screw_a = [30.0, 150.0, 270.0];
cup_screw_r = 34.27;
cup_ins_L = 4.0;
cup_ins_hole = 3.6;
driver_gasket_t = 1.0;
gasket_driver_squeeze = 0.3;
driver_rim_t = 2.0;
driver_rear_d = 50.4;
driver_depth = 14.0;
cup_ri = 26.75;
cup_ro = 31.67;
cup_h = 22.0;
cup_end_t = 2.0;
cup_boss_d = 6.1;
clamp_depth = 1.0;
cup_screw_clear = 2.9;
cup_csk_d = 5.1;
felt_t = 2.0;
felt_psa_w = 2.0;
felt_hole_d = 7.5;
rear_type = "open";
grille_pitch = 3.9;
grille_hole = 3.0;
vent_n = 3.0;
vent_d = 2.0;
vent_ring_r = 14.7125;
connector_size = [5.0, 9.8, 7.0];
anchor_h = 9.0;
clip_post_t = 5.0;
clip_post_L = 22.0;
arm_head_d = 5.5;
anchor_screw_grip = 4.0;
cable_od = 3.8;
clip_wall = 2.5;
clip_interf = 0.05;
clip_len = 8.0;
clip_gap = 1.2;
seal_od = 92.0;
seal_id = 62.0;
saddle_a = 95.0;
temporal_a = 20.0;
mastoid_a = 229.0;
cable_a = 285.0;
has_post = true;
post_a = 164.0;
post_r = 59.0;
pad_p_a = 33.8;
pad_p_b = 39.0;
link_mode = "cup";
link_a = 180.0;
link_r = 47.35;
eye_ins_hole = 3.6;
eye_ins_L = 4.0;
eye_boss_d = 8.0;
eye_boss_h = 6.0;
saddle_arch = true;
arch_R = 22.0;
arch_phi = 35.0;
saddle_liner_t = 2.5;
link_x = -18.0;
link_y = 7.0;
serrated = true;
serr_p = 1.2;
serr_h = 0.6;
anchor_screw_clear = 3.4;
anchor_head_d = 5.5;
anchor_ins_hole = 4.0;
anchor_ins_L = 5.0;
anchor_ins_pitch = 7.1;
mastoid_r = 58.0;
