joaoPauloPimentel/UNIVERSAL-MODULAR-EAR-MOUNTED-HEADPHONE-40-TO-600-MM-DRIVERS/(list of files, cad)

Other CAD files:
umeh2/stl/module_40mm/cup_cap_40_L.stl
umeh2/stl/module_45mm/cup_cap_45_L.stl
umeh2/stl/module_50mm/cup_cap_50_L.stl
umeh2/stl/module_55mm/cup_cap_55_R.stl
umeh2/stl/module_60mm/cup_cap_60_R.stl
umeh2/stl/module_40mm/cup_40_R.stl
umeh2/stl/module_60mm/cup_60_L.stl
umeh2/stl/module_45mm/cup_45_L.stl
umeh2/stl/module_50mm/cup_50_R.stl
umeh2/stl/module_55mm/cup_55_L.stl
umeh2/stl/common/ring_L.stl
umeh2/stl/common/arm_post.stl
umeh2/cad/params_40.scad
umeh2/cad/params_45.scad
umeh2/cad/params_50.scad
umeh2/cad/params_55.scad
umeh2/cad/params_60.scad
umeh2/stl/assembly/UMEH-2_assembly_40mm_R.stl
umeh2/stl/assembly/UMEH-2_assembly_45mm_R.stl
umeh2/stl/assembly/UMEH-2_assembly_50mm_R.stl
umeh2/stl/assembly/UMEH-2_assembly_55mm_R.stl
umeh2/stl/assembly/UMEH-2_assembly_60mm_R.stl
