joaoPauloPimentel/UNIVERSAL-MODULAR-EAR-MOUNTED-HEADPHONE-40-TO-600-MM-DRIVERS/umeh2/stl/assembly/UMEH-2_assembly_40mm_externo.png

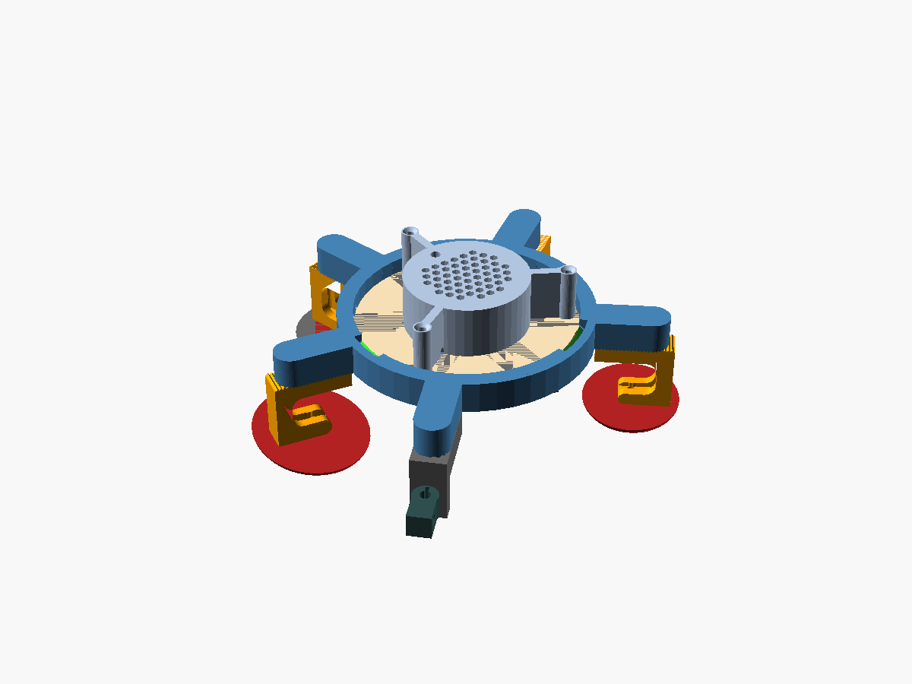
umeh2/stl/assembly/UMEH-2_assembly_40mm_externo.png
