joaoPauloPimentel/UNIVERSAL-MODULAR-EAR-MOUNTED-HEADPHONE-40-TO-600-MM-DRIVERS/umeh2/stl/assembly/UMEH-2_assembly_40mm_lado_da_cabeca.png

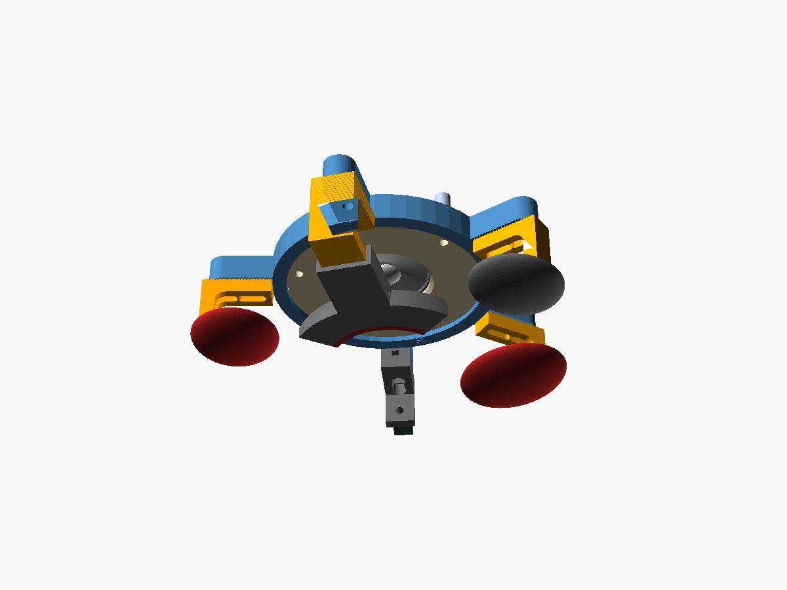
umeh2/stl/assembly/UMEH-2_assembly_40mm_lado_da_cabeca.png
