joaoPauloPimentel/UNIVERSAL-MODULAR-EAR-MOUNTED-HEADPHONE-40-TO-600-MM-DRIVERS/(commit log)

2026-09-28 Add UMEH-2 cradle sources with the final eye tune applied
    CAD, calculation pipeline and last results of the UMEH-2 ear-mounted cradle
    (40-60 mm drivers). final_layout.json carries the 5.0 N preload and the tuned
    per-module link eyes; results/ predate this tune and are being regenerated.
    Claude-Session: https://claude.ai/code/session_01YAJpo3WafE12ZaYEcyavBK
2026-09-28 UMEH-2: results after run_all INTERRUPTED Mon Sep 28 08:49:18 UTC 2026 by request (pause), during max_driver_mass (40-55 mm done in log, 60 mm running); resume: python3 run_all.py --resume
    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
    [generated_params.scad]
2026-09-29 UMEH-2: results after sweeps INTERRUPTED Tue Sep 29 04:50:00 UTC 2026 by request (3 h limit), just started; resume: sh pipeline.sh from sweeps (figures build_stl bom eye_record make_report after)
    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
    [generated_params.scad]
2026-09-30 UMEH-2: results after figures INTERRUPTED Wed Sep 30 04:40:06 UTC 2026 by request (pause after sweeps); resume: sh pipeline.sh (figures build_stl bom eye_record make_report)
    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
2026-09-30 UMEH-2: results after build_stl done Wed Sep 30 22:54:56 UTC 2026
    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
    [params_40.scad, params_45.scad, params_50.scad, params_55.scad, params_60.scad]
2026-09-30 UMEH-2: results after bom done Wed Sep 30 22:55:02 UTC 2026
    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
2026-09-30 UMEH-2: final report, README and BOM on the final design
    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
    [BOM.csv]
2026-09-30 UMEH-2: add the STL files of the final design
    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
    [arm_mastoid.stl, arm_post.stl, arm_saddle.stl, arm_temporal.stl, baffle_40.stl, baffle_45.stl, baffle_50.stl, baffle_55.stl]
2026-09-30 Traduz §9–§11 do relatório
2026-09-30 Traduz §12–§15 do relatório
2026-09-30 Traduz §16–§17 do relatório
2026-09-30 Traduz §18–§23 do relatório
2026-09-30 Traduz STATUS e tabela da BOM para o português
    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
2026-09-30 Add assembled 3D model per driver size (3MF, STL, renders)
    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
    [UMEH-2_assembly_40mm_R.3mf, UMEH-2_assembly_40mm_R.stl, UMEH-2_assembly_45mm_R.3mf, UMEH-2_assembly_45mm_R.stl, UMEH-2_assembly_50mm_R.3mf, UMEH-2_assembly_50mm_R.stl, UMEH-2_assembly_55mm_R.3mf, UMEH-2_assembly_55mm_R.stl]
2026-09-30 Assembly: add driver display model, rear felt and UMI foam; cut-away renders
    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
    [UMEH-2_assembly_40mm_R.3mf, UMEH-2_assembly_40mm_R.stl, UMEH-2_assembly_45mm_R.3mf, UMEH-2_assembly_45mm_R.stl, UMEH-2_assembly_50mm_R.3mf, UMEH-2_assembly_50mm_R.stl, UMEH-2_assembly_55mm_R.3mf, UMEH-2_assembly_55mm_R.stl]
2026-09-30 Add commercial finish: cup cap (cosmetic), CMF spec, cap in assembly files
    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
    [UMEH-2_assembly_40mm_R.3mf, UMEH-2_assembly_40mm_R.stl, UMEH-2_assembly_45mm_R.3mf, UMEH-2_assembly_45mm_R.stl, UMEH-2_assembly_50mm_R.3mf, UMEH-2_assembly_50mm_R.stl, UMEH-2_assembly_55mm_R.3mf, UMEH-2_assembly_55mm_R.stl]
2026-09-30 Add front foam between the pinna and the driver (2 mm reticulated PU)
    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
    [UMEH-2_assembly_40mm_R.3mf, UMEH-2_assembly_40mm_R.stl, UMEH-2_assembly_45mm_R.3mf, UMEH-2_assembly_45mm_R.stl, UMEH-2_assembly_50mm_R.3mf, UMEH-2_assembly_50mm_R.stl, UMEH-2_assembly_55mm_R.3mf, UMEH-2_assembly_55mm_R.stl]
